MichaelMIL/Desk_Buddy/3d/images/README.md

# Images

Renders and section diagrams of the RoundBot, made with OpenSCAD. The
assembly guide ([`../guide/assembly_guide.html`](../guide/assembly_guide.html))
and the READMEs show them; the "Used in" column says where.

## Lineups and overviews

| File | Shows | Used in |
|---|---|---|
| `c_themes_front.png` | The template and the first twelve themes, from the front | Main README, guide overview, 3d README |
| `c_themes_back.png` | The same thirteen, from the back | Guide overview |
| `c_themes_lap.png` | The ten builds that hold something on their lap, from the front | Main README, guide overview, 3d README |
| `c_themes_lap_back.png` | The same ten, from the back | Guide overview |
| `c_bands_lap.png` | The newer bands, and the Claude cups' engraved faces | Guide, lap themes |
| `c_x_dj.png` | Exploded view of the DJ build | Main README, guide overview |
| `c_x_bare.png` | Exploded view of the template | Guide, template |
| `c_skeleton.png` | The skeleton, front and back | Main README, guide, skeleton |
| `c_plate.png`, `c_plate2.png` | Parts in their print orientation | Guide, printing |

## Assembly steps

| File | Shows | Guide step |
|---|---|---|
| `c_s2.png` | The display sliding into the head shell | 2 |
| `c_g3.png` | The head going onto the neck | 3 |
| `c_g4a.png`, `c_g4b.png` | The wedge key sliding in, and seated | 4 |
| `c_diag_neck.png` | Sections through the neck lock | 4 |
| `c_g5.png`, `c_g5b.png` | The back cap and its posts | 5 |
| `c_g6a.png` | A plug and a cup from the inside: peg, lugs and spring beam | 6 |
| `c_g6b.png` | Side pieces and band going on | 6 |
| `c_diag_twist.png` | Section through the side piece twist‑lock | 6 |
| `c_diag_band_hook.svg` | Section through the band hook in a cup | 6 |
| `c_cradle_in.png`, `c_cradle.png` | The SuperMini sliding into the base plate's cradle, and seated | 7 |
| `c_base2.png` | The base plate going into the body | 8 |
| `c_usb_stops.png` | The USB notch with its two stops, the recess round the top and the sill across the bottom, and the cover beside it | 9 |
| `c_usb_in.png` | The USB cover in place, flush | 9 |
| `c_s8.png` | The finished back, with the USB cover | 9 |

## Not used

These show joints that have since been replaced. They are kept for
reference.

| File | Shows |
|---|---|
| `c_diag_clip.png` | The earlier band clip with two spring arms, next to the twist‑lock section (now `c_diag_twist.png`) |
| `c_base3.png`, `c_s6.png` | The earlier SuperMini mount, which the board was pressed down into |

When a joint changes, render new images here and update the guide; the
guide is the only place most of them appear.
