MichaelMIL/Desk_Buddy/docs/images/README.md

# README images

Pictures for the main [README](../../README.md).

| File | Shows |
|---|---|
| `faces.png` | The common faces: angry, happy, in love, kiss, sleepy, surprised, wink |
| `build_themes.png` | Animations for the build variants: DJ, cat, bear, bunny, king, unicorn |
| `themes.png` | Seasonal themes: Halloween, ocean, space, Christmas |
| `more_themes.png` | Skeleton, gamer, bee, devil, dragon, robot, birthday, valentine, summer |
| `claude_theme.png` | The Claude theme: thinking, writing, hello, spark, pondering, coding, tests pass, debugging, ship it |
| `claude_code.png` | Claude Code moments: reading, searching, editing, todo list, permission, build failed, … done |
| `claude_langs.png` | Claude and programming languages: Python, C++, Go, Rust, JavaScript, TypeScript, Java, C, SQL, bash, polyglot |
| `simulator.png` | The simulator |
| `editor.png` | The animation editor |
| `device_faces.png`, `device_settings.png` | The Faces and Settings web pages the firmware used to serve. The device has no web pages any more, so nothing shows these |

`sim/test/sheet.html?anim=<name>` shows a contact sheet like these for one
animation.
