MichaelMIL/Desk_Buddy/3d/stl/core/README.md

# Core parts

Every buddy needs these five, whatever its theme. Print them once; changing
themes only swaps the body and the accessories.

| File | What it does | Prints | Supports |
|---|---|---|---|
| `head_shell.stl` | Face bezel and display pocket, with a keyhole for a side piece on each side | Face down | None. 0.12 to 0.16 mm layers give a cleaner bezel |
| `head_cap.stl` | Back of the head. Its posts clamp the display, and it closes behind the neck key | Back face down | None |
| `neck_key.stl` | Wedge that slides in behind the display and locks the head onto the neck | Flat, as exported | None. Small and loaded: 4 walls or 100% infill |
| `base.stl` | Bottom plate that snaps into the body, with a cradle the SuperMini slides into from the back | Flat, cradle up | None |
| `usb_cover.stl` | Cover that clicks into the USB‑C notch from outside, flush, against a sill and a recess in the body. Print it in the body's colour | Outer face down | None |

Assembly order and fit tuning are in the
[assembly guide](../../RoundBot_v8_Assembly_Guide.pdf).
