MichaelMIL/Desk_Buddy/3d/stl/accessories/README.md

# Accessories

The side pieces twist‑lock into the keyholes on the head. The band's two
ends hook into the slots on top of a pair of cups, so every band needs two
cups. Builds without a band close the keyholes with plugs or pods.

## Side pieces

Print outer face down, no supports. The spring beam under the peg prints as
a 20 mm bridge, so keep the part fan on.

| File | What it is | Builds that use it |
|---|---|---|
| `cup_left.stl`, `cup_right.stl` | Plain headphone cups with a band slot on top | Every build with a band except Claude. Gamer uses only `cup_right` |
| `cup_mic.stl` | Left cup with a headset mic boom; the boom lies flat on the bed | Gamer |
| `cup_claude_left.stl`, `cup_claude_right.stl` | Cups with the Claude spark engraved 0.6 mm into the outer face | Claude |
| `plug.stl` | Closes a keyhole; fits either side, print two | Template, Skeleton |
| `pod_left.stl`, `pod_right.stl` | Astronaut comms pods, the right one with an antenna. `pod_left` is the same shape as `plug` | Astronaut |

## Bands

Print flat on the back face, no supports. The topper is part of the flat
outline, and so are the two end tabs with their hooks. To take a band off,
push an end in toward the head and lift it.

| File | Topper | Builds that use it |
|---|---|---|
| `band_plain.stl` | None | DJ, Gamer |
| `band_cat.stl` | Cat ears | Cat |
| `band_bear.stl` | Round ears | Bear |
| `band_bunny.stl` | Long ears | Bunny |
| `band_bug.stl` | Two antennae | Bug |
| `band_devil.stl` | Horns | Devil |
| `band_crown.stl` | A crown | King |
| `band_dino.stl` | Plates along the top | Dino |
| `band_unicorn.stl` | A grooved horn between two ears | Unicorn |
| `band_claude.stl` | The spark | Claude |
| `band_robot.stl` | An antenna with a ball | Robot |
| `band_halloween.stl` | A witch hat with a bent tip | Halloween |
| `band_xmas.stl` | Reindeer antlers | Christmas |
| `band_ocean.stl` | A shark fin | Ocean |
| `band_birthday.stl` | A party hat with a pom‑pom | Birthday |
| `band_valentine.stl` | A heart | Valentine's |
| `band_summer.stl` | A sun hat with a wide brim | Summer |
| `band_stpatricks.stl` | A shamrock on a stem | St. Patrick's |

Any band fits any pair of cups, so toppers mix freely. The bodies are in
[`../bodies/`](../bodies/).
