MichaelMIL/Desk_Buddy/3d/images/c_base3.png

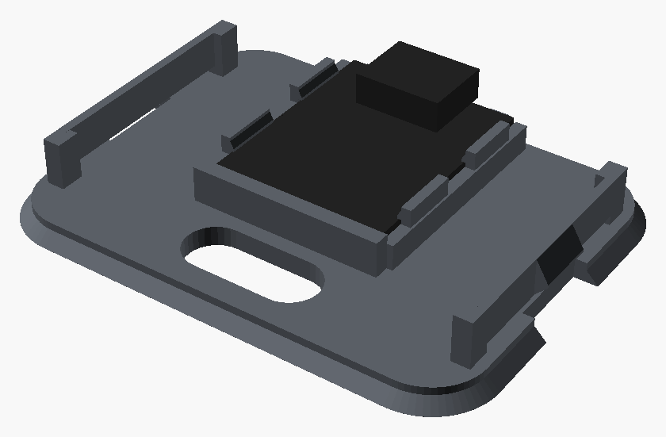
3d/images/c_base3.png
