MichaelMIL/Desk_Buddy/3d/images/c_diag_clip.png

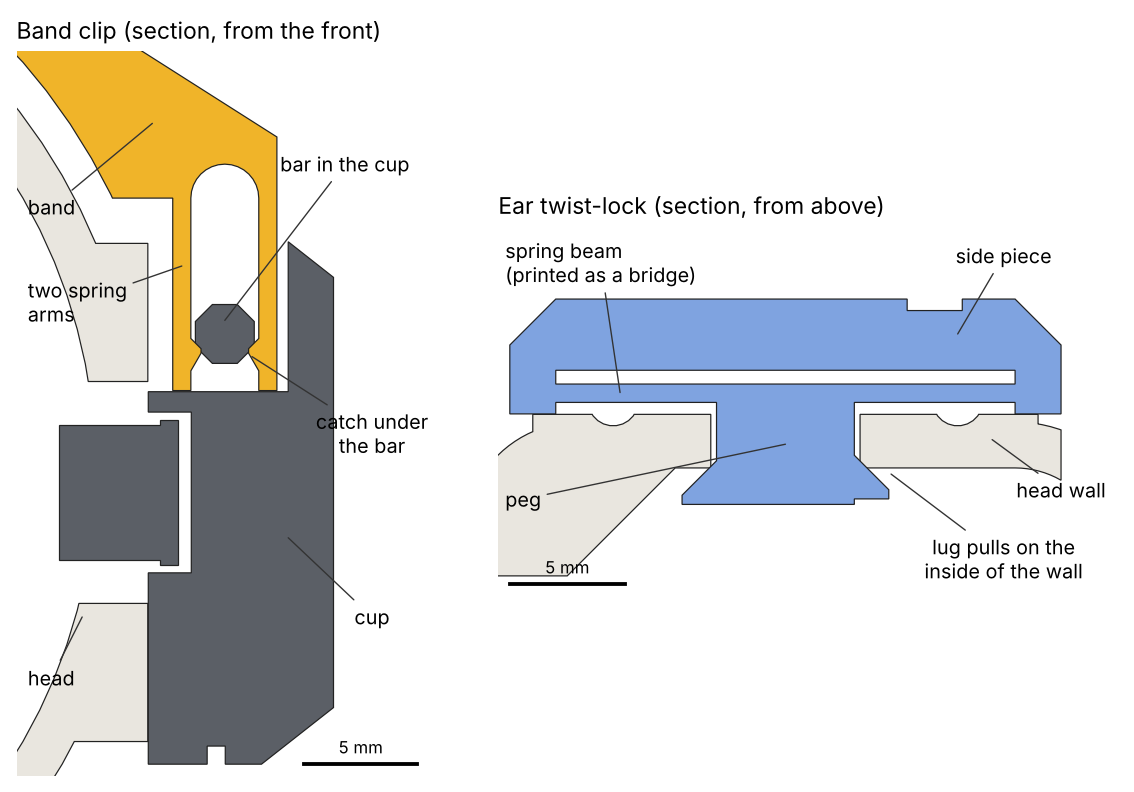
3d/images/c_diag_clip.png
