MichaelMIL/Desk_Buddy/3d/images/c_s6.png

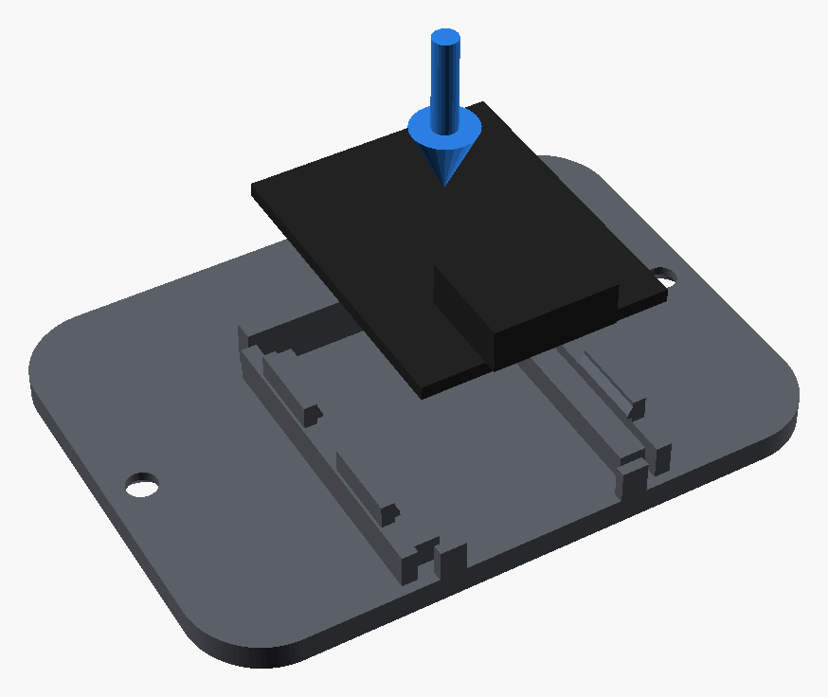
3d/images/c_s6.png
