MichaelMIL/Desk_Buddy/docs/images/device_faces.png

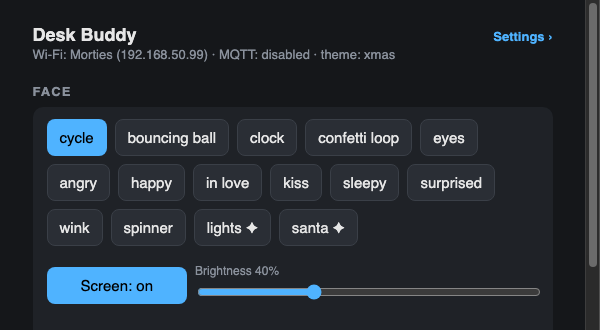
docs/images/device_faces.png
