MichaelMIL/Desk_Buddy/docs/images/device_settings.png

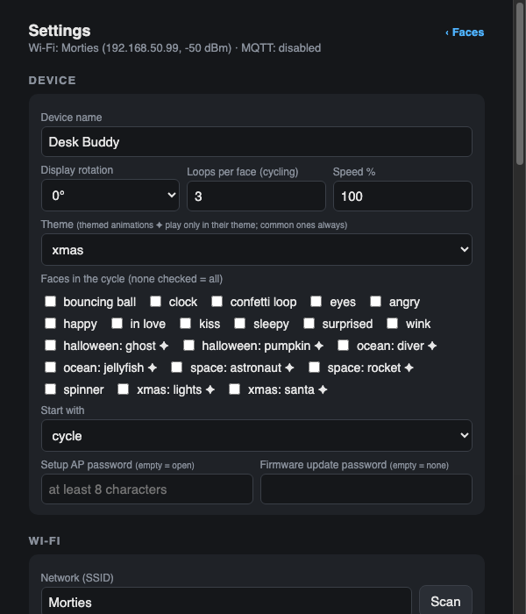
docs/images/device_settings.png
