MichaelMIL/Desk_Buddy/docs/tft_screen_1.PNG

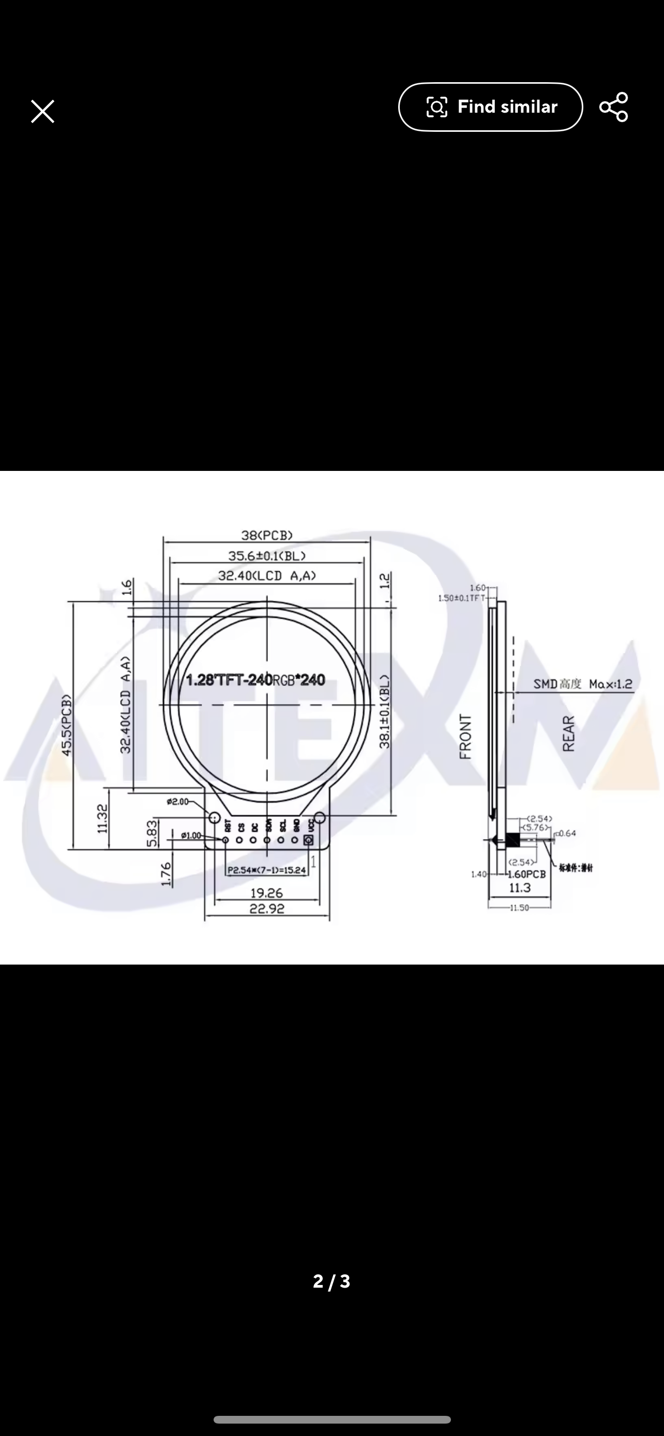
docs/tft_screen_1.PNG
