MichaelMIL/Desk_Buddy/docs/tft_screen_2.PNG

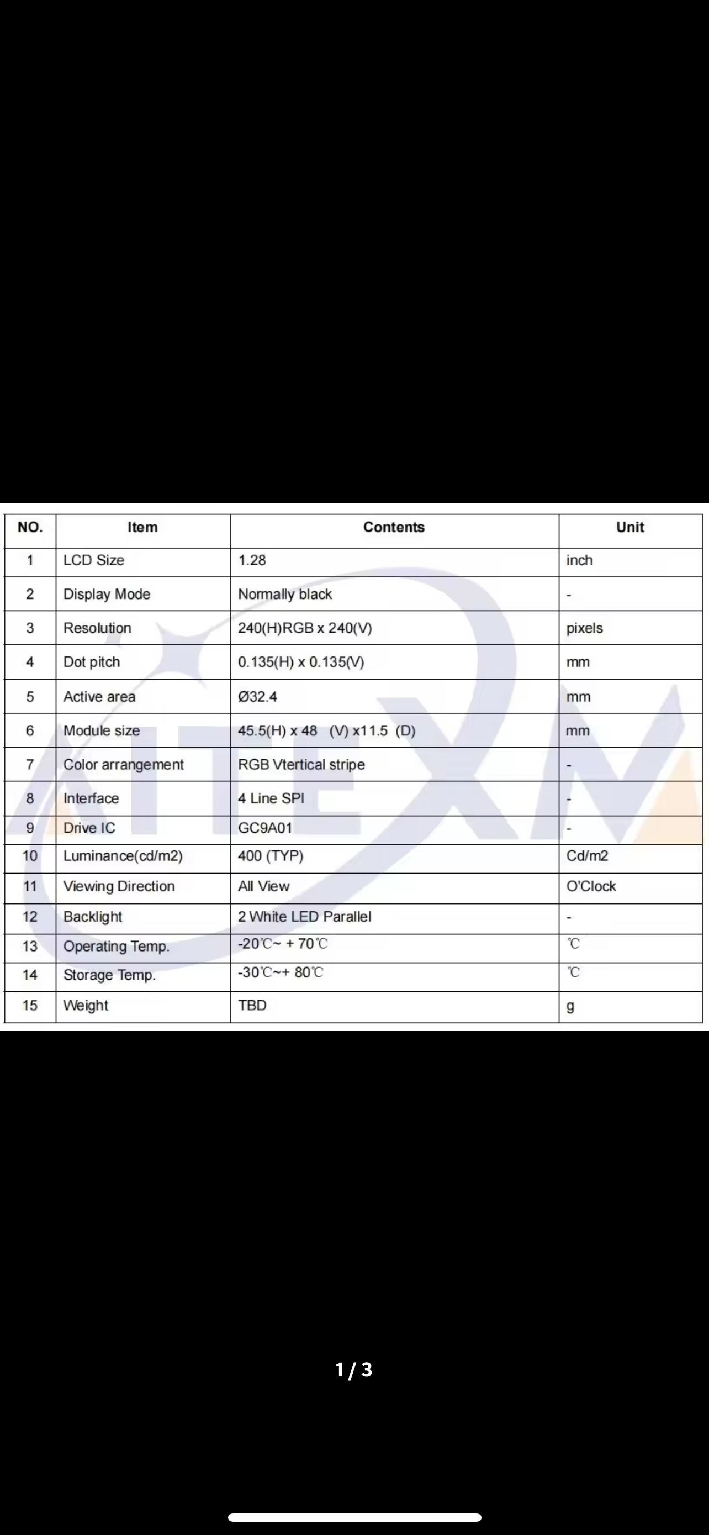
docs/tft_screen_2.PNG
