MichaelMIL/Desk_Buddy/docs/tft_screen_3.PNG

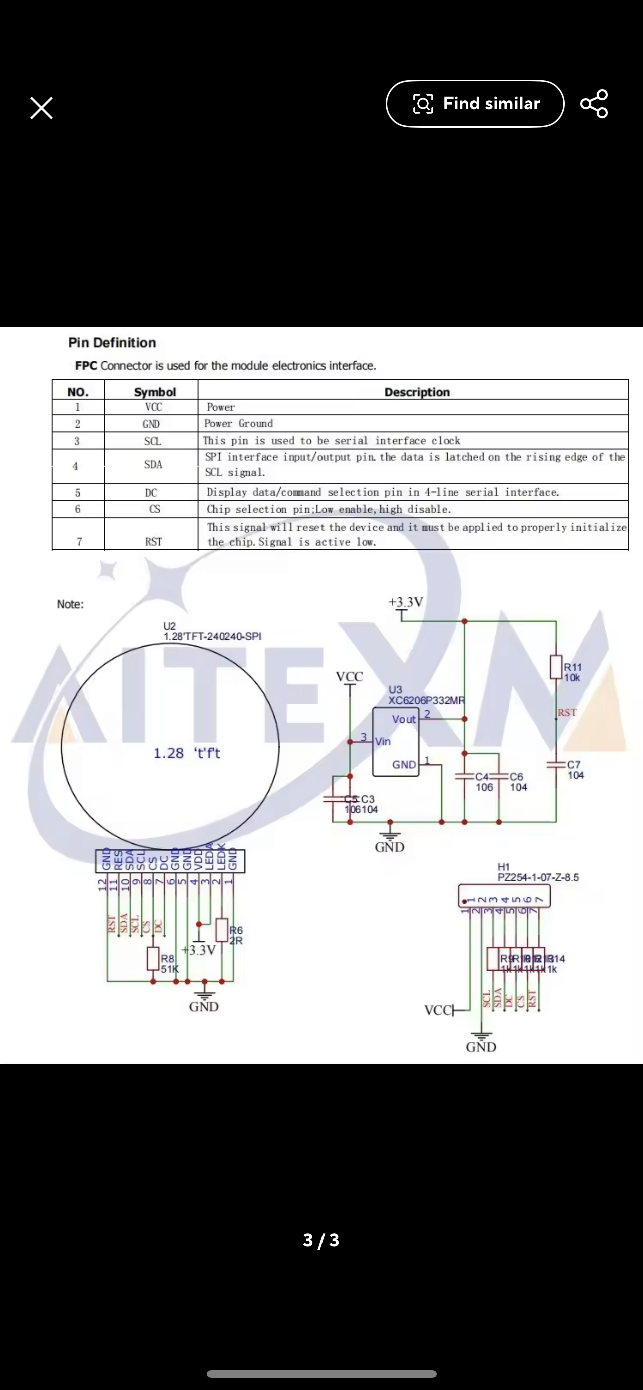
docs/tft_screen_3.PNG
