MichaelMIL/Desk_Buddy/3d/stl/accessories/band_robot.stl

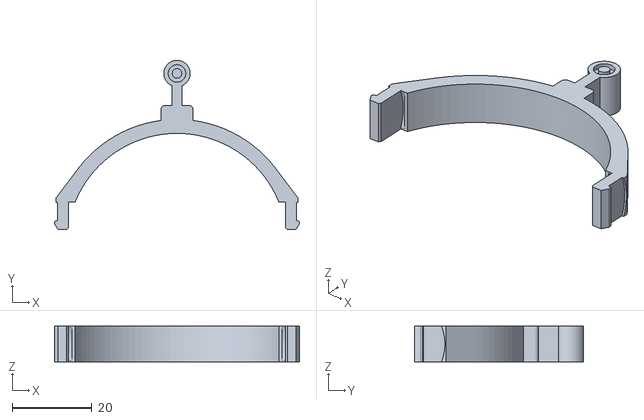
[picture p33: CAD file, 2026-11-12]
3d/stl/accessories/band_robot.stl
61.3 x 42.4 x 9.00
