MichaelMIL/Desk_Buddy/3d/stl/bodies/body_robot.stl

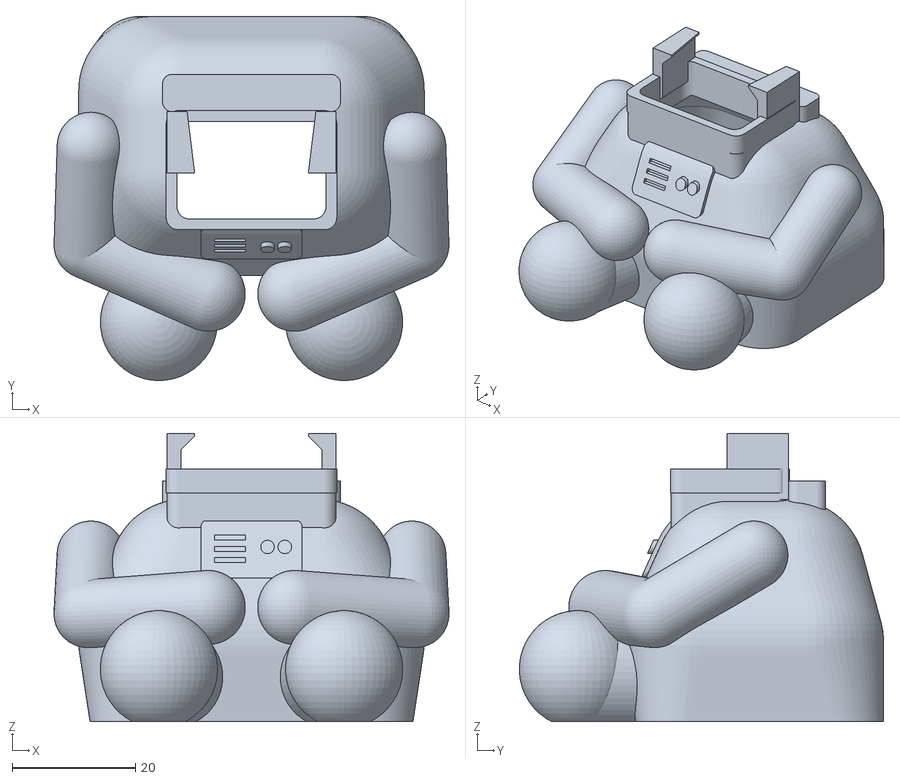
[picture p34: CAD file, 2026-11-14]
3d/stl/bodies/body_robot.stl
64.0 x 59.0 x 46.7
