MichaelMIL/Desk_Buddy/3d/stl/core/usb_cover.stl

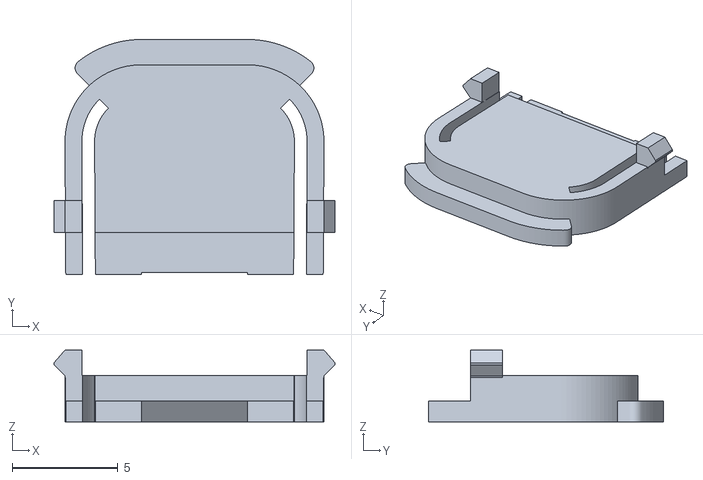
[picture p35: CAD file, 2026-11-14]
3d/stl/core/usb_cover.stl
13.3 x 11.1 x 3.40
