MichaelMIL/Desk_Buddy/3d/usb_variants/b_slide/stl/usb_cover.stl

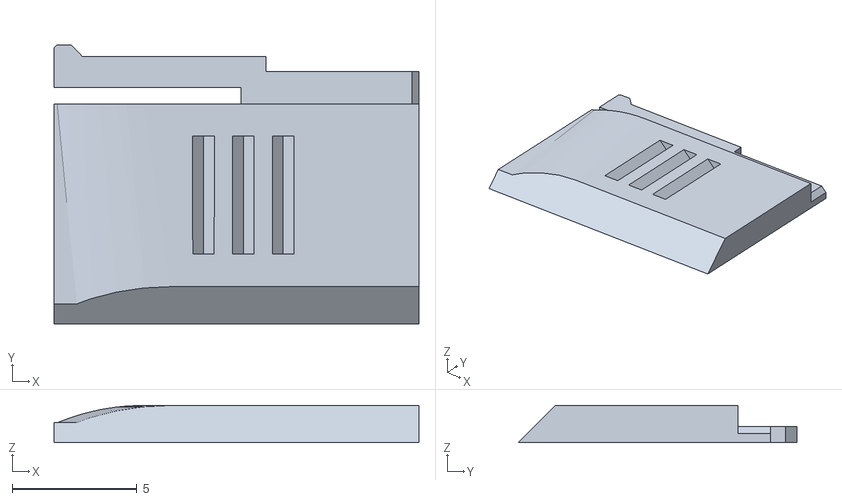
[picture p37: CAD file, 2026-11-14]
3d/usb_variants/b_slide/stl/usb_cover.stl
14.6 x 11.2 x 1.50
