MichaelMIL/Desk_Buddy/3d/usb_variants/d_magnet/stl/usb_cover.stl

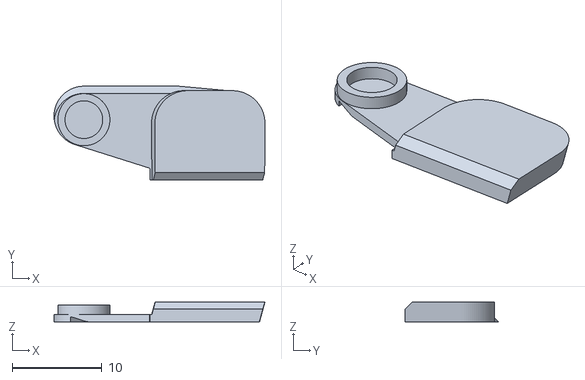
[picture p38: CAD file, 2026-11-14]
3d/usb_variants/d_magnet/stl/usb_cover.stl
23.5 x 10.4 x 2.20
