MichaelMIL/Desk_Buddy/3d/stl/accessories/band_xmas.stl

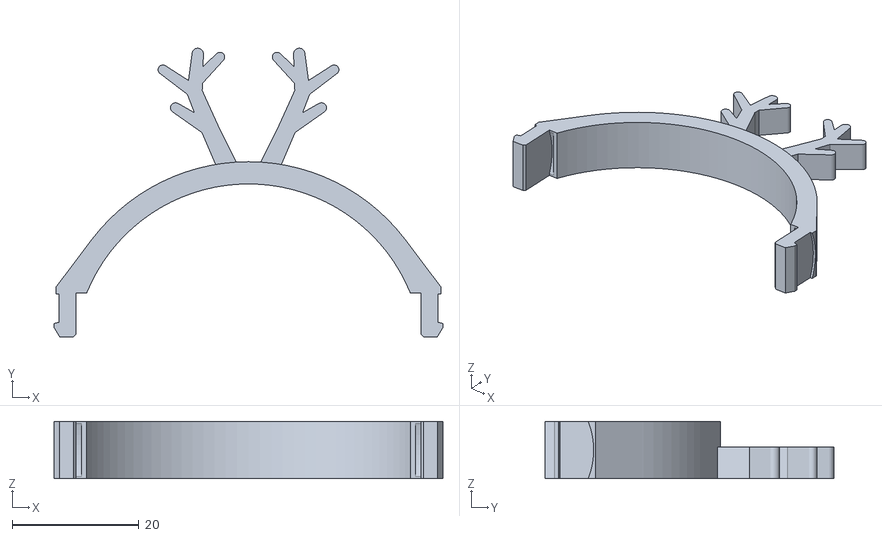
[picture p39: CAD file, 2026-11-12]
3d/stl/accessories/band_xmas.stl
61.3 x 45.5 x 9.00
