MichaelMIL/Desk_Buddy/3d/stl/bodies/body_claude.stl

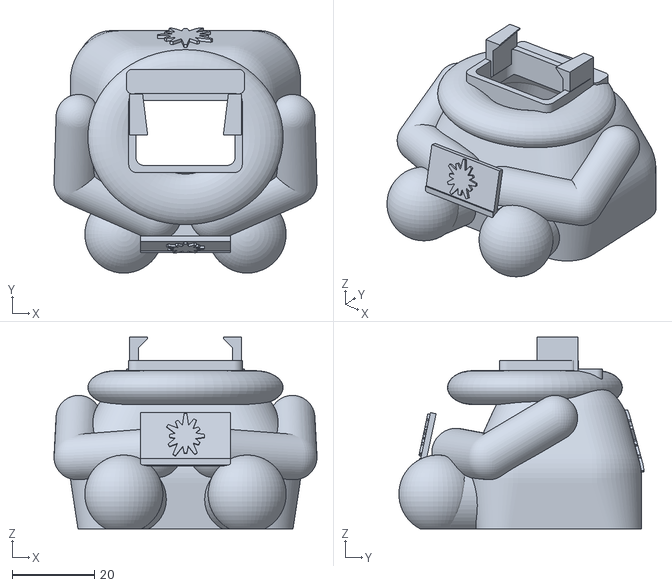
[picture p40: CAD file, 2026-11-14]
3d/stl/bodies/body_claude.stl
64.0 x 59.6 x 46.7
