MichaelMIL/Desk_Buddy/3d/stl/core/base.stl

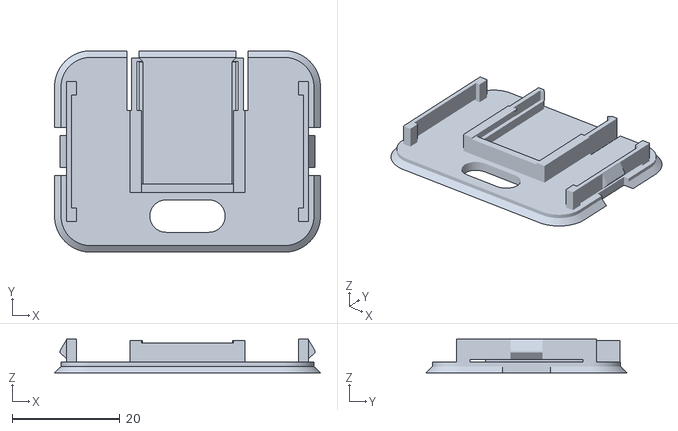
[picture p41: CAD file, 2026-11-12]
3d/stl/core/base.stl
49.4 x 37.4 x 6.30
