MichaelMIL/Desk_Buddy/3d/usb_variants/b_slide/stl/usb_test.stl

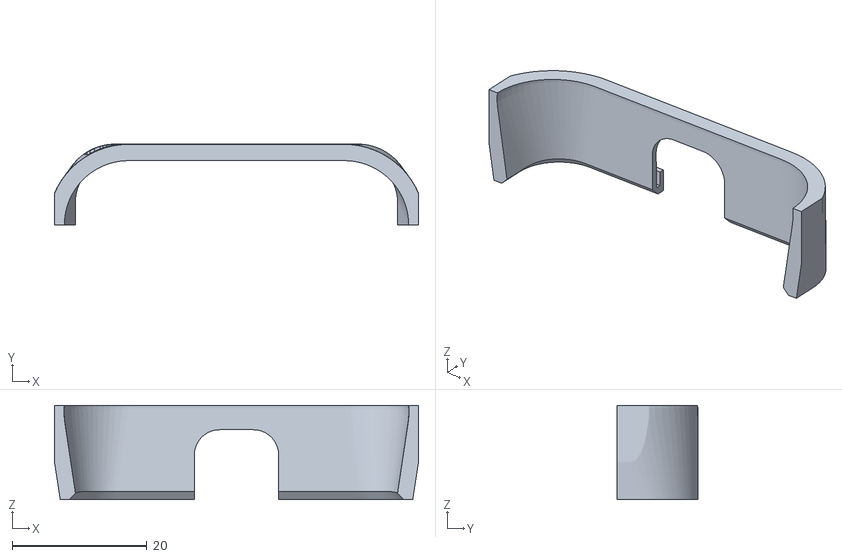
[picture p42: CAD file, 2026-11-14]
3d/usb_variants/b_slide/stl/usb_test.stl
54.0 x 12.0 x 13.9
