MichaelMIL/Desk_Buddy/3d/stl/accessories/band_halloween.stl

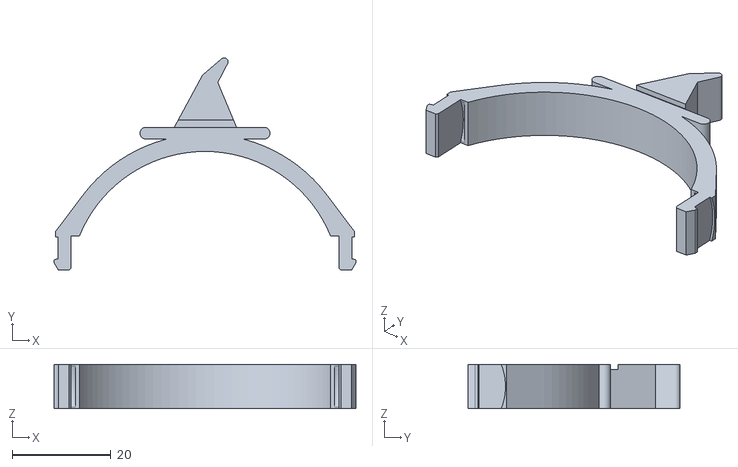
[picture p45: CAD file, 2026-11-12]
3d/stl/accessories/band_halloween.stl
61.3 x 43.1 x 9.00
