MichaelMIL/Desk_Buddy/3d/stl/bodies/body_cat.stl

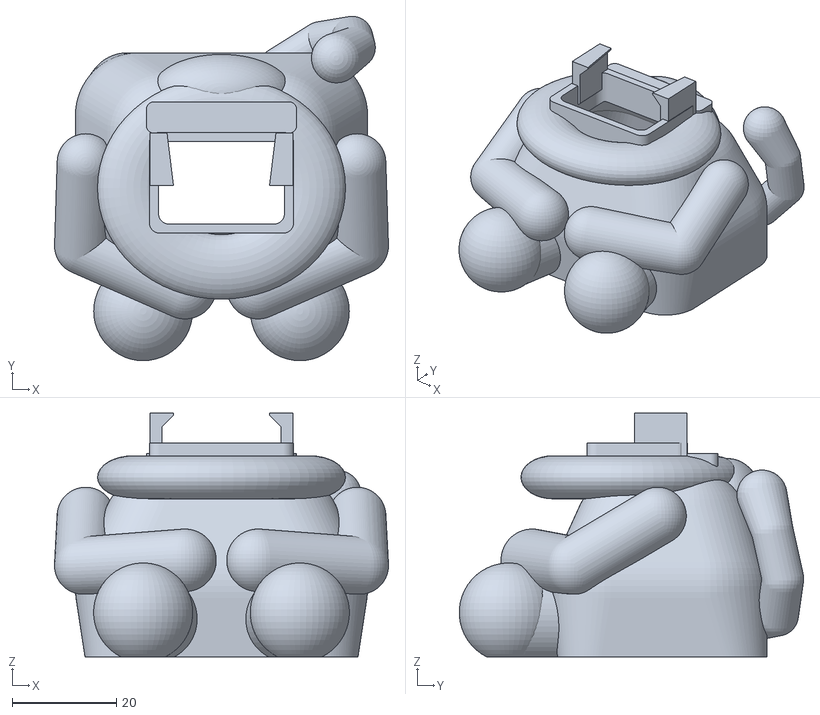
[picture p46: CAD file, 2026-11-14]
3d/stl/bodies/body_cat.stl
64.0 x 66.0 x 46.7
