MichaelMIL/Desk_Buddy/3d/stl/core/neck_key.stl

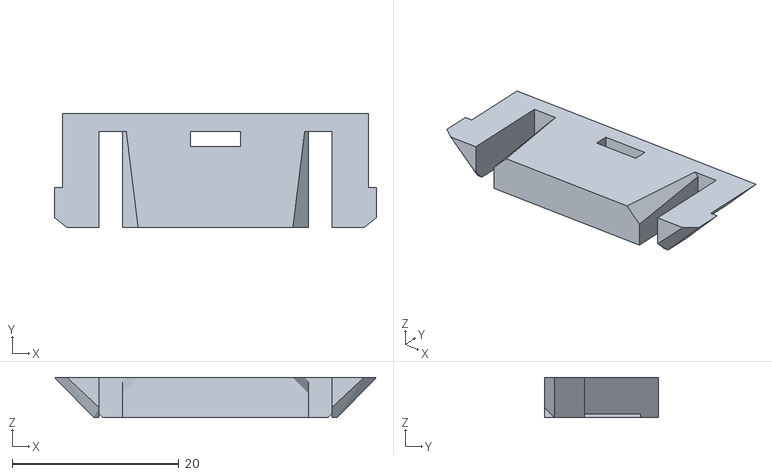
[picture p47: CAD file, 2026-11-11]
3d/stl/core/neck_key.stl
38.6 x 13.7 x 4.80
