MichaelMIL/Desk_Buddy/3d/usb_variants/e_slide/stl/usb_cover.stl

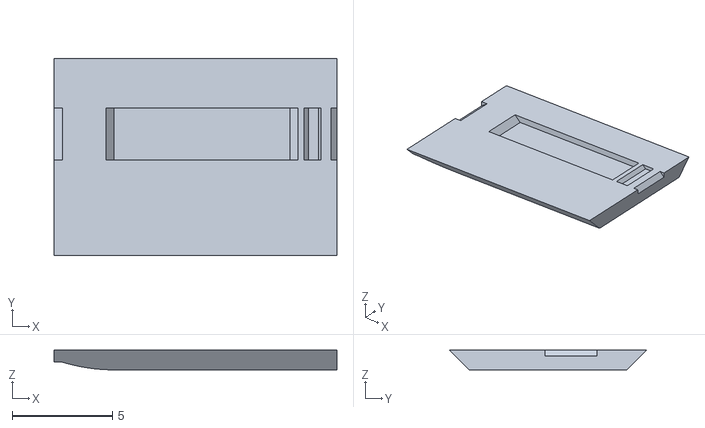
[picture p48: CAD file, 2026-11-14]
3d/usb_variants/e_slide/stl/usb_cover.stl
14.1 x 9.85 x 0.997
