MichaelMIL/Desk_Buddy/3d/stl/accessories/band_stpatricks.stl

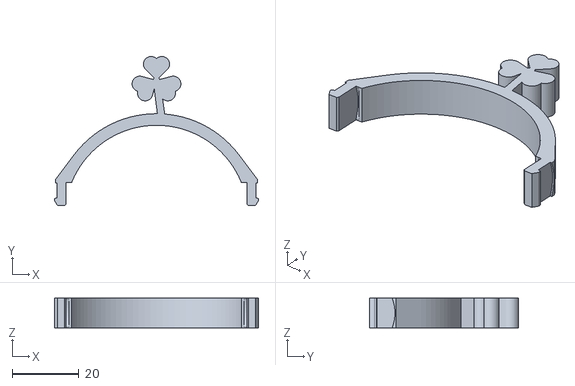
[picture p49: CAD file, 2026-11-12]
3d/stl/accessories/band_stpatricks.stl
61.3 x 44.8 x 9.00
