MichaelMIL/Desk_Buddy/3d/stl/bodies/body_summer.stl

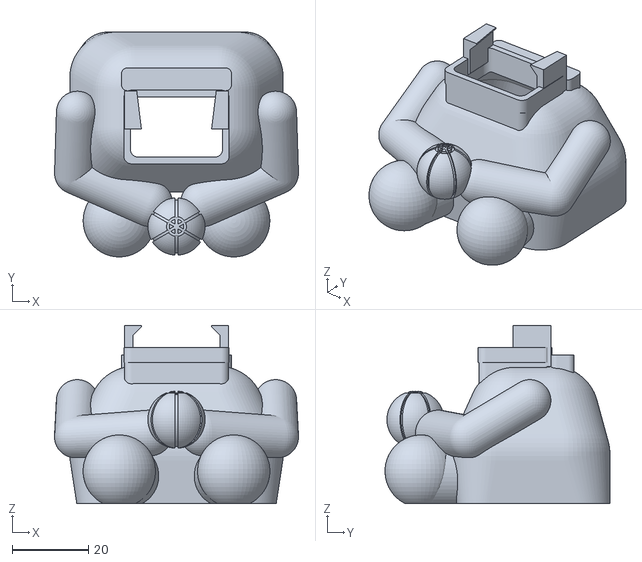
[picture p50: CAD file, 2026-11-14]
3d/stl/bodies/body_summer.stl
64.0 x 59.0 x 46.7
