MichaelMIL/Desk_Buddy/3d/stl/core/head_cap.stl

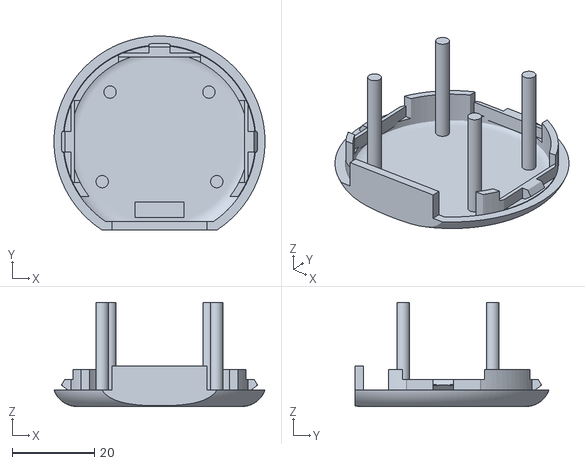
[picture p51: CAD file, 2026-11-11]
3d/stl/core/head_cap.stl
51.3 x 47.2 x 25.3
