MichaelMIL/Desk_Buddy/3d/stl/accessories/band_birthday.stl

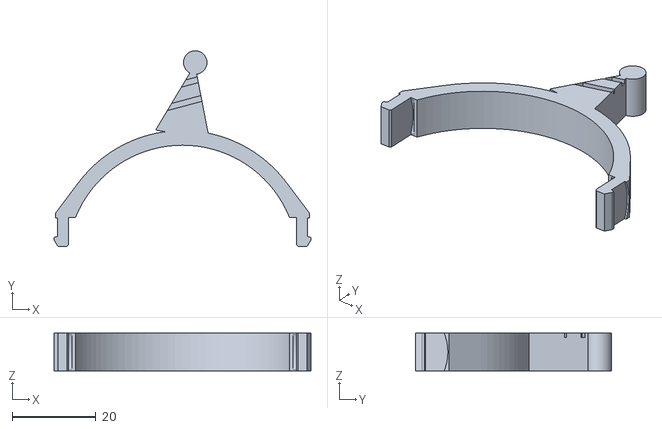
[picture p52: CAD file, 2026-11-12]
3d/stl/accessories/band_birthday.stl
61.3 x 46.6 x 9.00
