MichaelMIL/Desk_Buddy/3d/stl/bodies/body_astro.stl

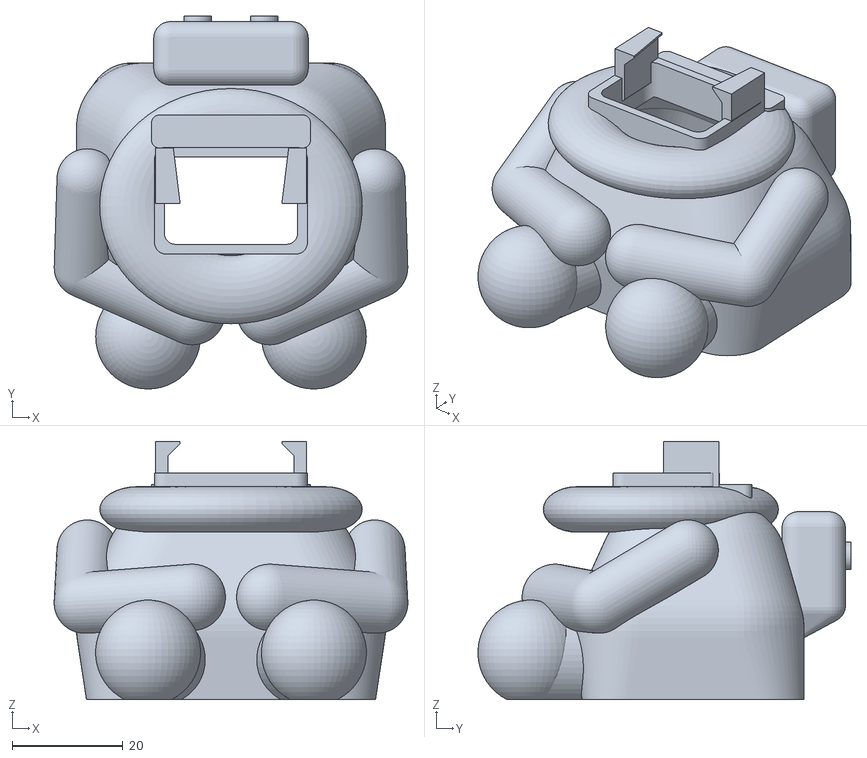
[picture p53: CAD file, 2026-11-14]
3d/stl/bodies/body_astro.stl
64.0 x 67.5 x 46.7
