MichaelMIL/Desk_Buddy/3d/stl/core/head_shell.stl

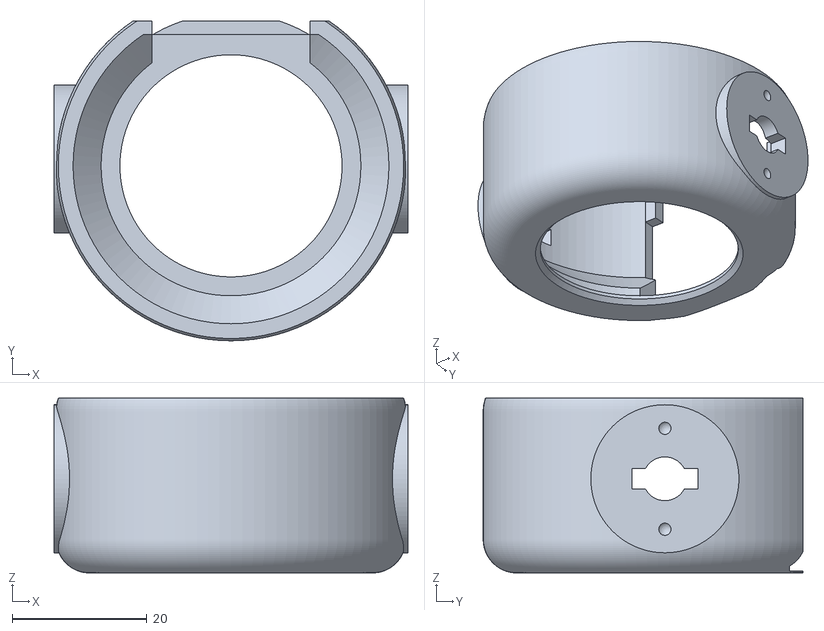
[picture p54: CAD file, 2026-11-11]
3d/stl/core/head_shell.stl
52.6 x 47.5 x 26.0
