MichaelMIL/Desk_Buddy/3d/stl/accessories/band_ocean.stl

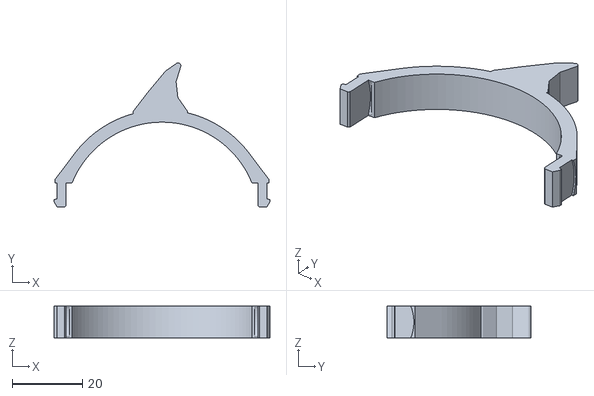
[picture p55: CAD file, 2026-11-12]
3d/stl/accessories/band_ocean.stl
61.3 x 40.9 x 9.00
