MichaelMIL/Desk_Buddy/3d/stl/accessories/band_summer.stl

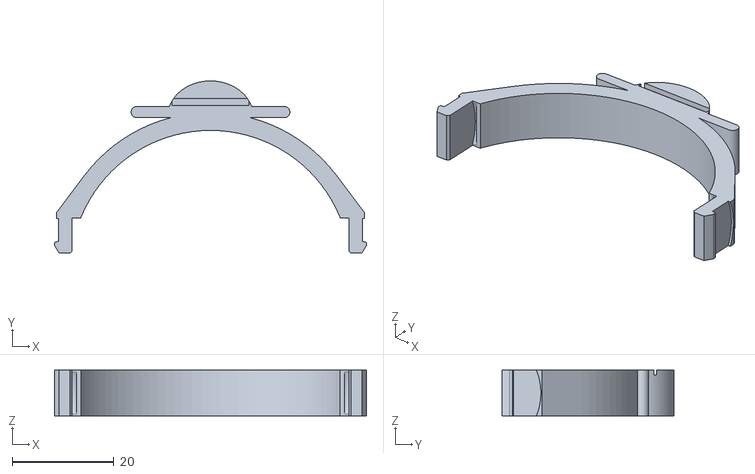
[picture p56: CAD file, 2026-11-12]
3d/stl/accessories/band_summer.stl
61.3 x 33.8 x 9.00
