MichaelMIL/Desk_Buddy/3d/stl/bodies/body_birthday.stl

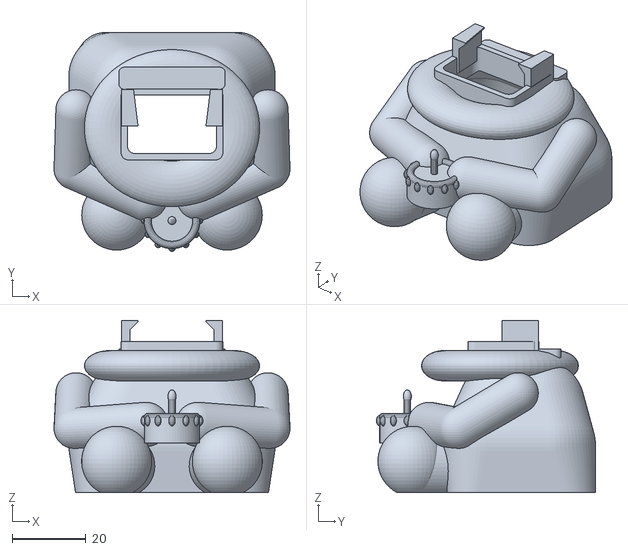
[picture p57: CAD file, 2026-11-14]
3d/stl/bodies/body_birthday.stl
64.0 x 59.4 x 46.7
