MichaelMIL/Desk_Buddy/3d/stl/accessories/band_valentine.stl

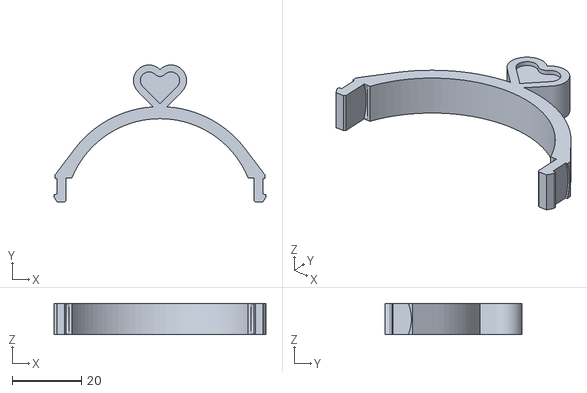
[picture p58: CAD file, 2026-11-12]
3d/stl/accessories/band_valentine.stl
61.3 x 39.6 x 9.00
