MichaelMIL/Desk_Buddy/3d/stl/accessories/cup_claude_left.stl

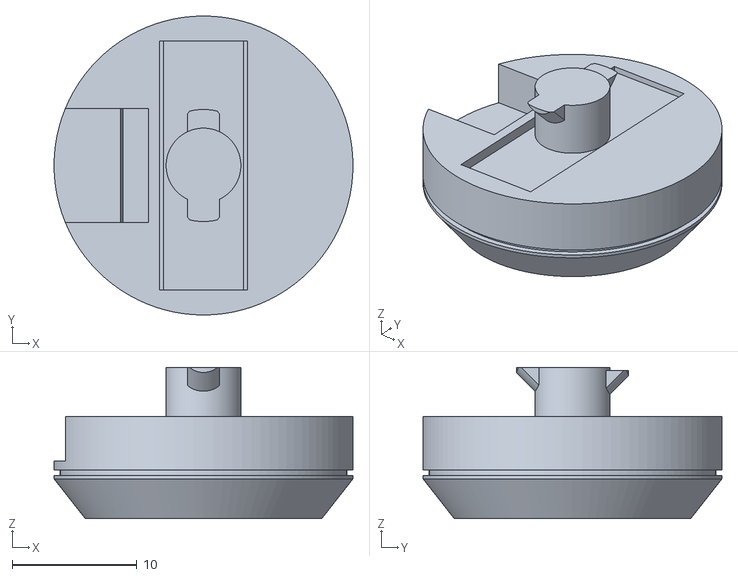
[picture p59: CAD file, 2026-11-12]
3d/stl/accessories/cup_claude_left.stl
24.0 x 24.0 x 12.1
