MichaelMIL/Desk_Buddy/3d/stl/bodies/body_skeleton.stl

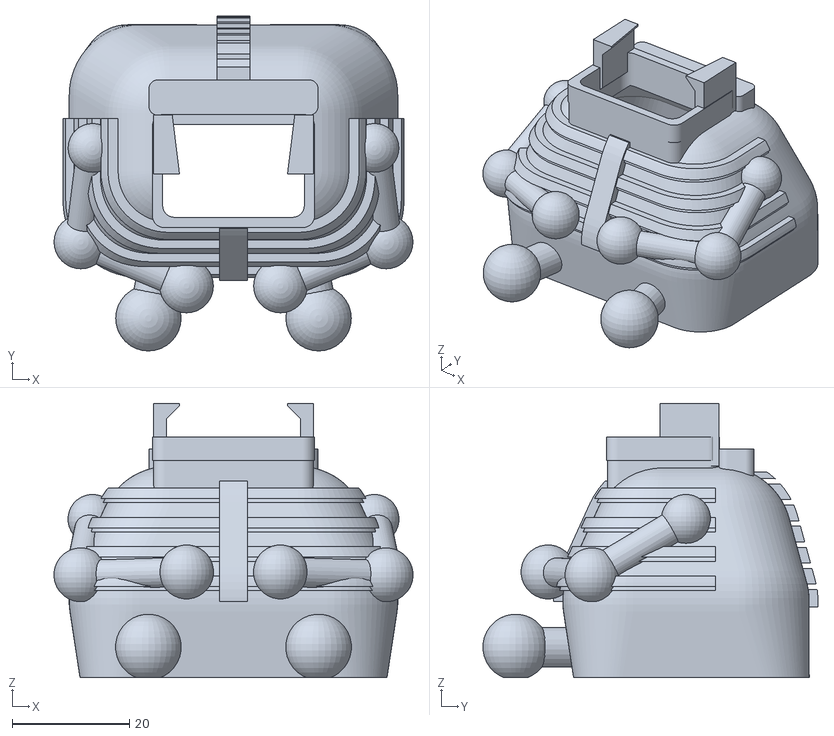
[picture p60: CAD file, 2026-11-14]
3d/stl/bodies/body_skeleton.stl
61.2 x 57.1 x 46.7
