MichaelMIL/Desk_Buddy/3d/stl/accessories/band_claude.stl

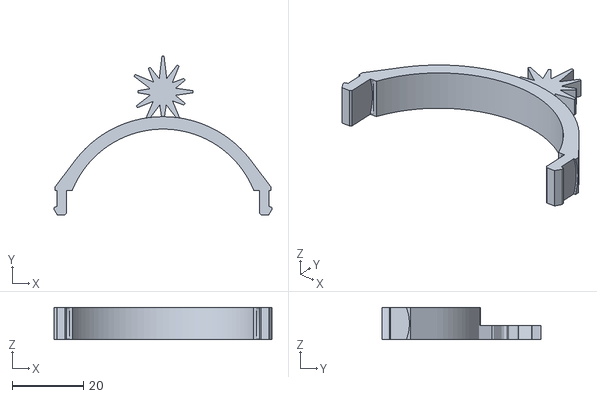
[picture p61: CAD file, 2026-11-12]
3d/stl/accessories/band_claude.stl
61.3 x 44.6 x 9.00
