MichaelMIL/Desk_Buddy/3d/stl/accessories/band_dino.stl

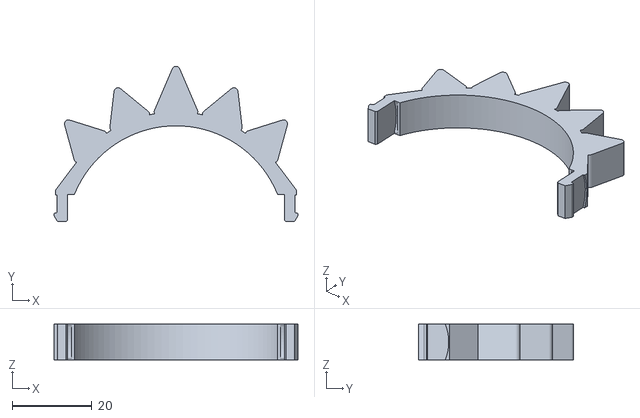
[picture p62: CAD file, 2026-11-12]
3d/stl/accessories/band_dino.stl
61.3 x 39.1 x 9.00
