MichaelMIL/Desk_Buddy/3d/stl/accessories/band_plain.stl

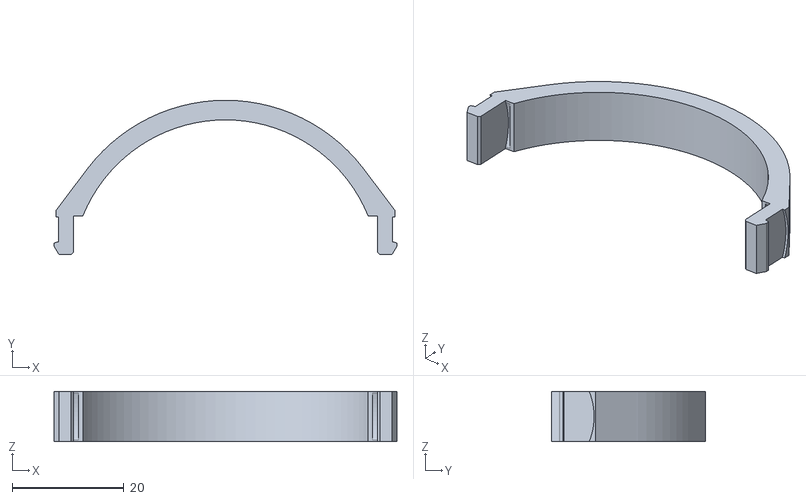
[picture p63: CAD file, 2026-11-12]
3d/stl/accessories/band_plain.stl
61.3 x 27.6 x 9.00
