MichaelMIL/Desk_Buddy/3d/stl/accessories/band_unicorn.stl

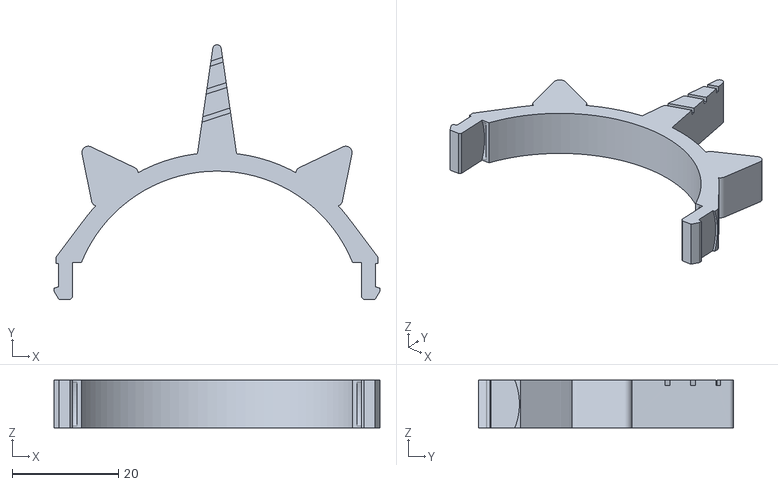
[picture p64: CAD file, 2026-11-12]
3d/stl/accessories/band_unicorn.stl
61.3 x 47.9 x 9.00
