MichaelMIL/Desk_Buddy/3d/stl/accessories/band_devil.stl

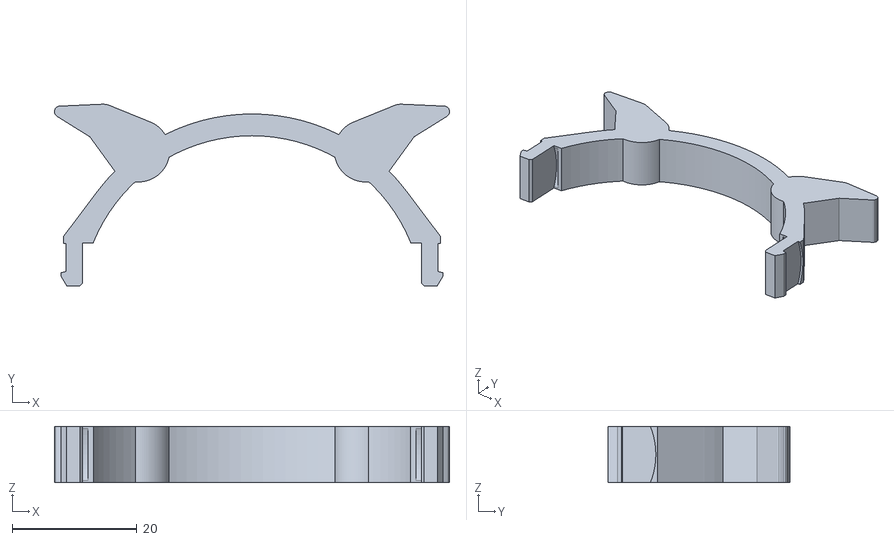
[picture p65: CAD file, 2026-11-12]
3d/stl/accessories/band_devil.stl
63.4 x 29.2 x 9.00
