MichaelMIL/Desk_Buddy/3d/stl/accessories/cup_mic.stl

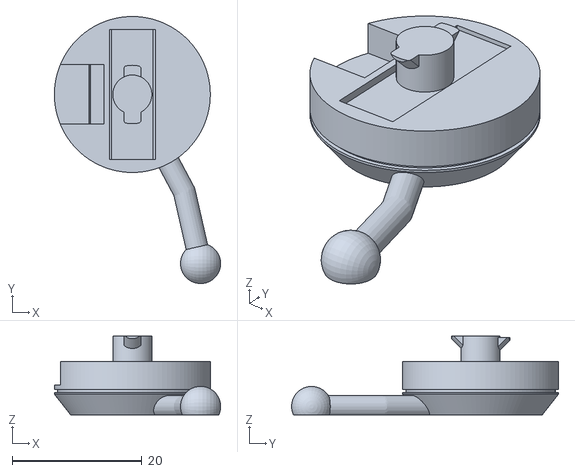
[picture p66: CAD file, 2026-11-12]
3d/stl/accessories/cup_mic.stl
25.6 x 41.1 x 12.1
