MichaelMIL/Desk_Buddy/3d/stl/accessories/band_bear.stl

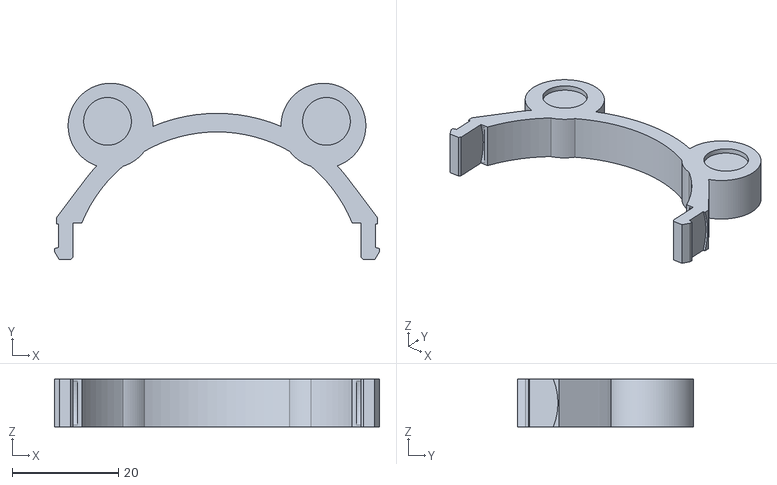
[picture p67: CAD file, 2026-11-12]
3d/stl/accessories/band_bear.stl
61.3 x 33.3 x 9.00
