MichaelMIL/Desk_Buddy/3d/stl/accessories/band_cat.stl

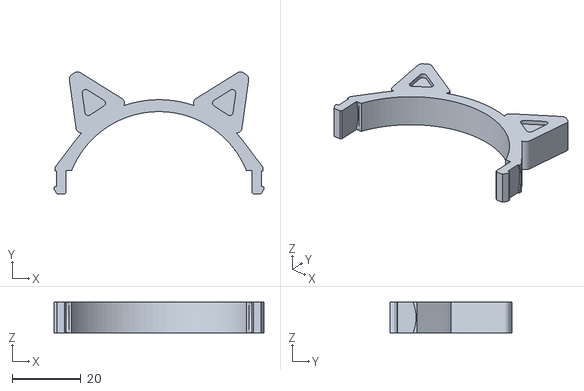
[picture p68: CAD file, 2026-11-12]
3d/stl/accessories/band_cat.stl
61.3 x 35.7 x 9.00
