MichaelMIL/Desk_Buddy/3d/stl/accessories/band_bug.stl

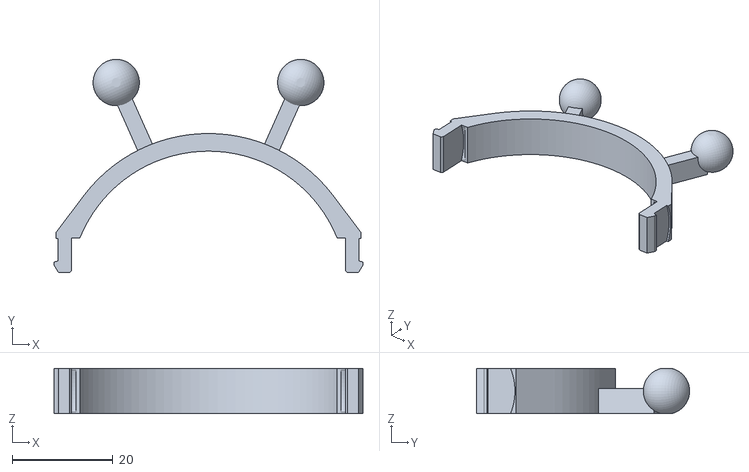
[picture p69: CAD file, 2026-11-12]
3d/stl/accessories/band_bug.stl
61.3 x 42.3 x 9.00
