MichaelMIL/Desk_Buddy/3d/stl/accessories/band_crown.stl

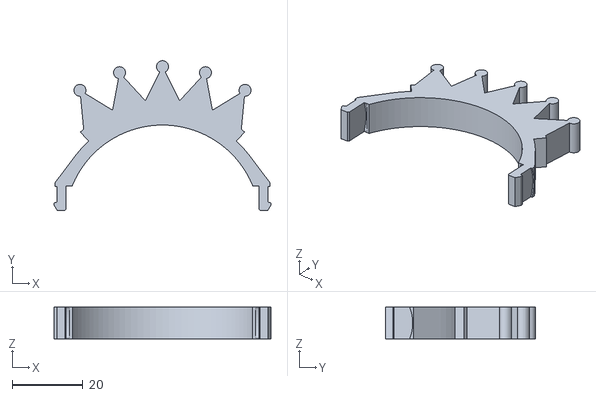
[picture p70: CAD file, 2026-11-12]
3d/stl/accessories/band_crown.stl
61.3 x 42.3 x 9.00
