MichaelMIL/Desk_Buddy/3d/stl/accessories/band_bunny.stl

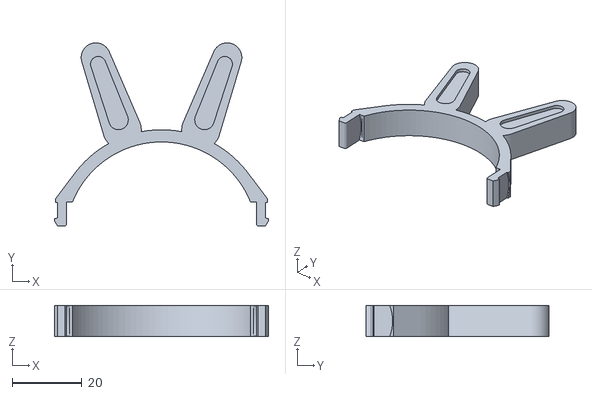
[picture p71: CAD file, 2026-11-12]
3d/stl/accessories/band_bunny.stl
61.3 x 52.5 x 9.00
