MichaelMIL/Desk_Buddy/3d/stl/accessories/pod_right.stl

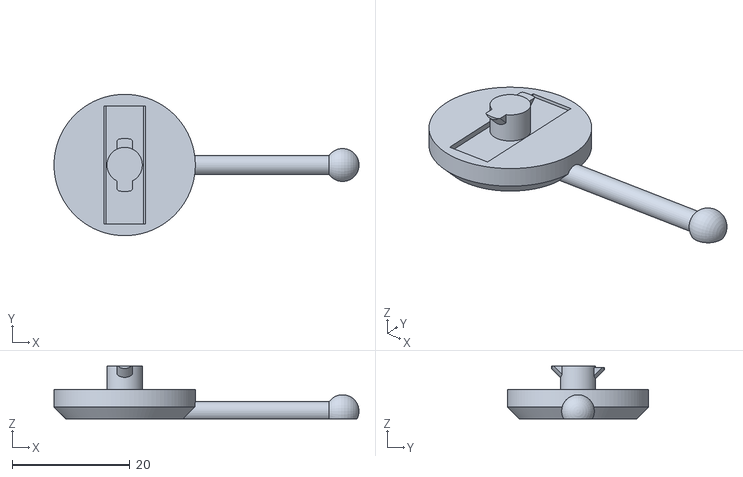
[picture p72: CAD file, 2026-11-11]
3d/stl/accessories/pod_right.stl
51.8 x 24.0 x 8.94
