MichaelMIL/Desk_Buddy/3d/stl/accessories/pod_left.stl

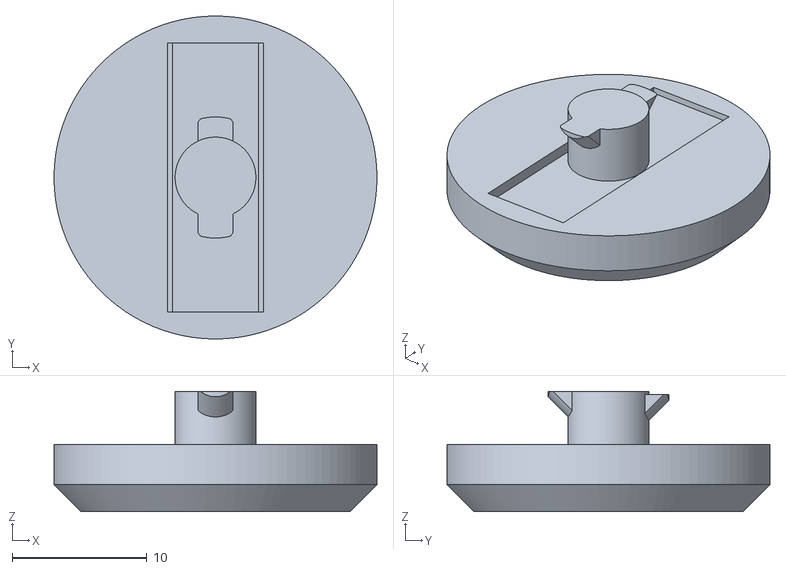
[picture p73: CAD file, 2026-11-11]
3d/stl/accessories/pod_left.stl
24.0 x 24.0 x 8.94
