MichaelMIL/Desk_Buddy/(list of files, cad)

Other CAD files:
3d/usb_variants/e_slide/stl/body_bare.stl
3d/usb_variants/b_slide/stl/body_bare.stl
3d/usb_variants/d_magnet/stl/body_bare.stl
3d/stl/bodies/body_bare.stl
3d/stl/bodies/body_valentine.stl
3d/stl/bodies/body_halloween.stl
3d/stl/accessories/cup_claude_right.stl
3d/stl/bodies/body_stpatricks.stl
3d/stl/bodies/body_ocean.stl
3d/stl/bodies/body_hoodie.stl
3d/stl/accessories/cup_left.stl
3d/stl/bodies/body_gamer.stl
3d/stl/bodies/body_xmas.stl
3d/stl/accessories/cup_right.stl
3d/stl/accessories/plug.stl
