MichaelMIL/Desk_Buddy/tools/firmware/wiring.html

# Desk Buddy firmware

what to connect to what

## Settings

The same settings as on the Build page: change them here or there.

## Parts

## Wiring diagram

## Connections
