MichaelMIL/Desk_Buddy/(commit log)

2026-11-11 Desk Buddy: TFT simulator, Claude chat, ESP32-S3 firmware with OTA, themes and 3D model
    - sim/: browser simulator for the 1.28" round GC9A01 display, pixel-exact
    RGB565 framebuffer, face helpers, themed animations, DBA1/DBAZ export,
    Claude Code chat backend, push-to-board with progress
    - hardware/: PlatformIO firmware for the ESP32-S3 SuperMini: setup AP,
    Wi-Fi, web pages, MQTT + Home Assistant discovery, LittleFS animation
    store with deflate, OTA, two-core rendering, brightness, themes
    - 3d/: RoundBot enclosure (OpenSCAD) and assembly guide
    [band_bear.stl, band_bug.stl, band_bunny.stl, band_cat.stl, band_crown.stl, band_devil.stl, band_dino.stl, band_plain.stl]
2026-11-11 Add root README with images, animation gallery page, pumpkin ridge fix
    [band_bear.stl, band_bug.stl, band_bunny.stl, band_cat.stl, band_crown.stl, band_devil.stl, band_dino.stl, band_plain.stl]
2026-11-11 Add build-variant themes (dj, cat, bear, bunny, king, unicorn) and a third animation per seasonal theme
    [band_bear.stl, band_bug.stl, band_bunny.stl, band_cat.stl, band_crown.stl, band_devil.stl, band_dino.stl, band_plain.stl]
2026-11-11 Crown: four points and gems within the band; push_all accepts a name filter
2026-11-12 Sim: animation editor (visual keyframes + code), FaceRig, shared board module
    - sim/editor.html + lib/editor.js: pose the face on a timeline (sliders,
    poses, draggable keys with easing, undo/redo) or edit any animation as code
    with a live preview; save to sim/animations/, push to the board with progress
    - animations/face_rig.js: keyframed face SPECs (the editor's file format)
    - lib/board.js: board names, rendering to DBAZ and push, shared with app.js
    - simulator: Edit button, editor link, reloads when the editor saves
    - new face made with the editor: Face: giggle
    - also adds animations made with the chat: DJ groove, St. Patrick's (lucky
    clover, lucky hat, pot of gold)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
2026-11-12 Nine new themes, 18 animations: skeleton, gamer, bee, devil, dragon, robot, birthday, valentine, summer
    - FaceRig accepts under/over drawing hooks, so code animations reuse the
    keyframed face and add accessories and props
    - Face.grin draws only the lower half-ellipse: the old background-coloured
    cover box cut into the eyes on wide grins and showed as a dark bar on
    coloured backgrounds (King: coins)
    - gallery.html waits for every animation file before rendering
    [band_bear.stl, band_bug.stl, band_bunny.stl, band_cat.stl, band_crown.stl, band_devil.stl, band_dino.stl, band_plain.stl]
2026-11-12 Every theme has at least three animations: 14 new ones, plus face fixes
    New: Bear snooze, Bee dance, Birthday balloons, Bunny curious, Cat laser,
    Devil trident, Dragon sneeze, Gamer game over, King cheers, Robot error,
    Skeleton laugh, Summer beach ball, Unicorn magic, Valentine kiss.
    - Face.eye: the squint cover ellipse is only painted on the eye's own rows;
    at small squints it sat below the eye and erased whatever was drawn there
    - robot ledEye takes a colour and an 'x' shape
    - clearer text in the gamer animations, skeleton laugh text on the forehead,
    a brighter, shorter dragon sneeze
    - README galleries re-rendered
2026-11-12 Claude theme: 16 more Claude Code moments, shared claude_kit.js
    Reading, grep, a diff, a todo list, a permission prompt, a failing then
    fixed build, a merge conflict, code review, CI, subagents, compacting,
    rubber-duck debugging, an infinite loop, a git graph, plan mode, done.
    The Claude drawing helpers (spark, terminal, spinner, colours) move to
    animations/claude_kit.js so several theme files can share them.
    [serve.py]
2026-11-12 Bands: bigger hook with a friction-locking catch, thicker tab, yoke at the cup
    The bands kept falling out of the cups. The hook is now 0.8 mm (was 0.45) and its
    catch is 15 degrees off flat (was 30), so pulling on the band no longer cams the hook
    out; to remove a band, push its end towards the head and lift. The tab fills the
    slot (0.05 mm at the wall, 0.08 mm front and back) and the band thickens into a
    yoke over its last ~9 mm that sits on the cup past the slot. The cup's decorative
    groove moves out to clear the yoke. All bands and cups re-exported.
    [band_bear.stl, band_bug.stl, band_bunny.stl, band_cat.stl, band_crown.stl, band_devil.stl, band_dino.stl, band_plain.stl]
2026-11-12 Firmware: build without Wi-Fi, uploads over USB and Bluetooth, API docs
    A Bluetooth + USB build (esp32s3_supermini_ble, 3.3 MB LittleFS), one upload
    path shared by HTTP, serial and BLE that refuses a second concurrent upload,
    hardware/API.md and hardware/BLE.md, and the simulator's push to usb / ble.
    [partitions_ble.csv]
2026-11-12 Phone app: Flutter remote for the buddy over Bluetooth LE
    Scan, pairing, remote, console and device status for iOS, Android and macOS,
    with a fake buddy for tests and a device test against a real board.
2026-11-12 3D: Claude build (laptop body, spark band, engraved cups)
    [band_claude.stl, cup_claude_left.stl, cup_claude_right.stl, round_bot.scad]
2026-11-12 3D Claude build: wider spark rays, add body_claude.stl
    The sparks on the lid, back, band and cups get wider rays and blunter tips so they
    print cleanly, and the body STL that was left out of 7b9f707 is added.
    [band_claude.stl, body_claude.stl, cup_claude_left.stl, cup_claude_right.stl, round_bot.scad]
2026-11-12 Phone app: buddy settings, delete, shared links, current firmware
    The firmware now runs every console command for a paired device, so the
    app does more than playback:
    - Buddy settings: rename, Wi-Fi network (quoted names with spaces,
    passwords the buddy would trim are refused), restart. The app expects
    the restart and reconnects (four tries).
    - Long-press a face to play or delete it.
    - The console masks passwords in wifi, mqtt and appass.
    - The scanner also lists buddies already connected to the phone or Mac
    (getSystemDevices): a connected buddy does not advertise.
    - The device name is read from status in both builds; the build without
    Wi-Fi prints "name: X, build without Wi-Fi ..."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
2026-11-12 Firmware: LZMA (DBAL) animations, config commands, USB uploads survive BLE drops
    - store.cpp unpacks the DBAL container (LZMA, lib/dba_player/lzma_dec.c)
    besides DBAZ and raw DBA1
    - the renderer draws a frame's delay-0 records back to back (frames whose
    changes are far apart arrive as several rectangles)
    - new console commands: config (settings JSON), start <name>|cycle,
    ha on|off, otapass; wifi takes a quoted SSID with spaces
    - a Bluetooth disconnect aborts only an upload Bluetooth owns; one running
    over USB carries on
    - firmware 2026.11.12d
2026-11-12 Sim: export animations as DBAL (LZMA), split frames into rectangles
    - lib/lzma.js and tools/dba.py encode DBAL byte-identically; pushes fall
    back to DBAZ for firmware from before DBAL
    - a frame whose changes are far apart becomes several small rectangles
    when that compresses smaller
    - serve.py holds the Claude bridge off the Bluetooth link during ble pushes
    - export_all.html waits until every animation file has loaded
    - tests: LZMA decoder against xz streams, DBAL round trips in JS/Python/C
2026-11-12 Remote page: every console command
    Playback (speed, loops, rotation, start face, cycle list), stored
    animations with upload and delete, Wi-Fi and MQTT settings, device
    actions, and a console; settings come from the new config command.
2026-11-12 Claude Code bridge: drive the buddy over Bluetooth LE
    - host ble / ble:<name>: state, names and play over the Nordic UART
    service with bleak; the link is released 20 s after the last command
    - hold <s> frees the link for uploads; a polyglot activity for languages
    without their own animation
2026-11-12 3D: theme bodies and bands
    Bodies holding a lap item for gamer, robot, halloween, xmas, ocean,
    birthday, valentine, summer and stpatricks; matching bands for all but
    gamer.
    [band_birthday.stl, band_halloween.stl, band_ocean.stl, band_robot.stl, band_stpatricks.stl, band_summer.stl, band_valentine.stl, band_xmas.stl]
2026-11-12 Buddy Bridge: macOS menu bar app for the Claude Code bridge
    claude_integration/menubar/ is a SwiftUI menu bar app (macOS 13+). Its
    icon follows the bridge: the activity on the buddy (reading, editing, ...),
    needs you, holding off, paused, not running, or a warning when the hooks
    are missing or the buddy does not answer. The panel lists the link and
    whether it is connected, each session's project and activity, the recent
    plays, and Pause/Resume, hold, stop, open log and open at login.
    It polls the daemon's GET /status, which now also reports the link,
    whether it is connected, the seconds left of a hold and the daemon's pid.
    build.sh --install builds the .app into ~/Applications; swift test c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
2026-11-12 Assembly guide: every body and accessory, the band hook, the slide-in cradle
    The guide is now built from 3d/guide/assembly_guide.html (node 3d/guide/build_pdf.mjs).
    It lists all 22 builds and all 46 STLs, has a Claude section and the lap-item themes,
    rewrites steps 6, 7 and 9 for the band hook, the ESP32 cradle and the outside USB cover,
    and updates fit tuning (btab_*, mcu_hook, ucv_bite, base_play). New renders: the lap
    themes from the back, the new bands and Claude cups, the cradle, a band hook section.
    README: the body section and the theme lineup point at it.
2026-11-12 Buddy Bridge: buddy controls, Manual mode and hold in the menu bar app
    The daemon owns the buddy link and serves GET/POST /buddy (play, cycle, next, brightness,
    screen, theme); the app shows the buddy's state, a face menu by theme, a Follow Claude /
    Manual switch (pause/resume) and "leave the buddy alone for 2 min" (hold).
2026-11-12 READMEs for 3d/ and docs/ and their subfolders
    What each folder holds, the STLs per folder, every image and where it is used (with the
    guide step), how to rebuild the assembly guide. The root README links 3d/README.md and
    docs/README.md.
2026-11-12 Buddy Bridge: Cycle mode, 3D modeling and design activities
    The menu bar app's switch is Follow Claude / Manual / Cycle; in Cycle the buddy goes
    through the common faces plus one theme's. The bridge plays claude__3d_modeling and
    claude__designing for 3D model and stylesheet/design files and tools.
2026-11-12 Animations: eating, attention, notifications, breaks, silly, rude, scientist theme
    25 new animations:
    - Eat: cookie, noodles, hungry
    - Attention: hey, puppy eyes, knock knock
    - Notify: bell, message, alert
    - Break: coffee, stretch, time for a break, water, breathe
    - Silly: raspberry, cross-eyed, googly eyes, squish
    - rude theme: middle finger, fart, eye roll, talk to the hand (only
    cycles while the rude theme is selected)
    - scientist theme: eureka, experiment, atom (goggles and wild hair)
    hand_kit.js (window.Hands) draws the cartoon hands they share. The
    generic demos move into a template theme (template_*.js) so they leave
    the common cycle.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
2026-11-12 Animation library: re-upload removed animations when they are played
    sim/serve.py saves every push in a local library
    (~/.config/desk-buddy/library or $DESK_BUDDY_LIBRARY) and serves it
    (/api/library); sim/test/library.sh exports every animation into it.
    When a played animation is no longer on the buddy, the Claude Code
    bridge (and the menu bar app through it), the phone app and
    sim/remote.html upload it from the library, deleting the least recently
    played library-backed ones while the buddy is out of space. App builds
    pack the library into assets (tool/sync_library.sh).
    [serve.py]
2026-11-13 Bridge: stop waits until the daemon has exited
    `buddy_bridge.py stop` returned as soon as the daemon answered POST /stop,
    while it was still putting the buddy back and holding the port and the
    Bluetooth link, so `stop && start` found the old daemon and did nothing.
    stop_daemon() now waits for the daemon's pid to go away (up to 60 s).
    install, demo and uninstall use it instead of sleeping for a second.
2026-11-14 3D: stops for the USB cover
    The cover only touched the base plate's cone at its bottom tip, so it
    could be pushed in or tilt. Every body now has two stops 1 mm behind the
    outer face, both outside the cable plug's path: a sill across the bottom
    of the notch (0.6 mm behind the wall's inner face so the USB receptacle
    clears it when the plate goes in) and a recess round the top for a rim on
    the cover. The rim only sits above the spring strips' roots so they stay
    free. ucv_bite 0.3 -> 0.4, so the teeth latch 0.3 mm before the stops.
    All 15 bodies and usb_cover re-exported. Guide steps 8 and 9, fit tuning
    and the PDF updated, with two new images of the stops.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
    [body_astro.stl, body_bare.stl, body_birthday.stl, body_cat.stl, body_claude.stl, body_gamer.stl, body_halloween.stl, body_hoodie.stl]
2026-11-14 Battery level: divider on GPIO 1, low battery alert, shown in every app
    Firmware (hardware/src/battery.*): a 100k/100k divider from the LiPo's B+
    to GPIO 1, read every 2 s through the eFuse-calibrated ADC and mapped to a
    percentage with a LiPo curve. A pull-down probe every 30 s tells a wired
    divider from a floating pin. `battery` / `battery cal <mV>` on the console,
    `bat`/`batLow` in the state JSON, battery in /api/status, an MQTT topic and
    a Home Assistant sensor. At 15 % (until 20 %) the buddy plays battery_low
    (or a text screen) every 5 min, every minute at 5 %, then resumes.
    New animation "Battery: low" (sim/animations/battery.js); battery_* names
    never join the cycle. The phone app, s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
2026-11-14 Firmware builds without battery level; low battery alerts take turns
    BUDDY_BATTERY=0 (envs esp32s3_supermini_nobat, esp32s3_supermini_ble_nobat,
    hardware/ota.sh --nobat) compiles the battery measurement and alerts out,
    ~11 KB less; state, config and /api/status then carry no battery fields,
    so every client shows none. Same partition tables, so switching keeps the
    stored animations. Replaces -DBAT_PIN=-1.
    Low battery alerts now rotate through the battery_* animations on the
    buddy in name order, with battery_critical first at 5 % and below when the
    buddy has it; the text screen when there are none.
    [battery.cpp, battery.h, config.h, main.cpp, net.cpp]
2026-11-14 Charging: the charger's CHRG/STDBY pads, charging alerts, shown in every app
    The TP4056's status pads go through Schottky diodes to GPIO 2 (CHRG) and
    GPIO 4 (STDBY) with the internal pull-ups (BAT_CHRG_PIN / BAT_STDBY_PIN);
    a change counts once it holds for 2 s. Unwired, nothing changes.
    Plugged in: charging_plugged_in, then every 10 minutes while charging the
    other charging_* in turn; charged: charging_full once per time on the
    charger. No low battery alerts while on the charger. charging_* never
    join the cycle.
    The state and battery JSON carry "chg":"charging"/"full" while on the
    charger; the phone app, sim/remote.html, the bridge and the menu bar app
    show a bolt or "charged", and a low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
2026-11-14 Battery and charging animations
    Low battery alerts (the firmware plays them in turn, battery_critical at
    5% and below): plug me (a USB-C plug dangles, puppy eyes, "plug me in!"),
    please (praying hands, speech bubbles, a tear), sos (the eyes blink
    S-O-S in Morse), hungry (chomps at a passing lightning bolt), faint
    (spiral eyes, X eyes, drops off screen, comes back) and critical (the
    picture collapses like an old TV switching off).
    Charging faces, stored as charging_* so the low rotation never picks
    them: plugged in and full (loop: false, played once on plug-in and when
    charged), power up (a gradient ring round the edge fills, each segment
    keeps its colour so frames stay small), sip (a batter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
2026-11-14 Battery and charging animations: random picks from pools, with settings
    The firmware sorts battery_* and charging_* animations into five pools by
    name (low, critical, plugged, charging, full) and plays a random one from
    the pool (not the same one twice in a row), at random times between half
    and one and a half times the interval. An empty critical pool uses the
    low one, an empty plugged pool the charging one.
    Settings, saved on the buddy: `alerts low off|<min>` (default 5) and
    `alerts charging off|0|<min>` (default 10; 0 = only when plugged in and
    when charged); `alerts test <pool>` plays one now. Also in config, and
    alertLow / alertCharging in POST /api/config. The phone app and
    sim/remote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
2026-11-14 Docs: hardware/PINOUT.md, parts and wiring on one page
    Every GPIO, the parts list, and the display, battery and charger wiring,
    linked from the README, hardware/README.md and CLAUDE.md.
2026-11-14 Tools: firmware builder GUI (Wi-Fi, Bluetooth, USB serial only, battery) in tools/fw_builder
    fw_builder.py opens a local page (127.0.0.1, random token) to pick the
    settings in options.json. Each setting maps to a PlatformIO environment and
    -D flags. It builds in hardware/.pio/fw_builder, copies the firmware to
    tools/fw_builder/out/ (ignored), and can flash over USB or update over
    Wi-Fi. It also has --list, --plan and --build on the command line. Tests:
    python3 tools/fw_builder/test_fw_builder.py.
2026-11-14 Tools: firmware Wiring tab, charging status toggle, buddy-themed look
    wiring.html, a third tab: what to connect to what for the selected
    settings. An SVG diagram shows the display on the SuperMini, and with
    battery level the LiPo, TP4056 charger, 1N5817, divider and (with charging
    status) the BAT54s to CHRG / STDBY. Below it a connection table with a
    check after each stage and the parts list, all changing with the toggles,
    which are shared with the Build tab. Pins are not typed in: POST
    /api/wiring resolves the macros the build would see (header defaults,
    the env's platformio.ini build_flags following extends, then the
    settings' -D flags), so moved or disabled pins show up. Scrolls sideways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
2026-11-14 Tools: firmware flash layout map and animation capacity estimate
    The Build tab has a Flash layout card for the selected settings. It draws
    the build's partition map over the 4 MB flash, address 0 on the left:
    bootloader, partition table, settings, OTA state, app slot(s),
    animations (LittleFS), crash dump. A table of offsets and sizes sits
    below. The app is shaded by the firmware size once that exact build
    exists. The Flash tab shows the same map for the chosen image (from its
    partition table) and a small one for the board after Connect.
    The estimate counts how many animations fit in the LittleFS partition.
    Files take whole 4 KB blocks, the directories a few, and uploads keep
    FS_MARGIN free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
2026-11-14 3D: USB cover variants to print and compare
    3d/usb_variants/ holds four ways to cover the USB-C notch: A (the
    click-in cover in round_bot.scad today), B (slide), D (magnet) and E (a
    second slide fixing the first print round's feedback). Each has its own
    .scad including round_bot.scad, STLs (a 15-minute test coupon, the cover,
    the bare body), pictures and a README; compare.png shows them side by side.
    round_bot.scad gets an empty usb_body_extra() hook for their body parts.
    [body_bare.stl, round_bot.scad, usb_clip.scad, usb_cover.stl, usb_magnet.scad, usb_slide.scad, usb_slide2.scad, usb_test.stl]
2026-11-14 App: animation previews, gallery and theme colors
    The app now plays the animations themselves instead of emoji. lib/dba.dart
    is a Dart port of hardware/lib/dba_player/ (DBAL/DBAZ containers, LZMA,
    DBA1 frames to RGBA), and test/dba_test.dart checks it against
    sim/tools/dba.py with two fixtures. lib/previews.dart decodes them on a
    background isolate and caches them.
    - Remote: the round screen in its bezel plays the buddy's animation.
    - Previews: tap a face to watch it at the buddy's speed, with its theme,
    length and size, then play it, send and play it, switch to its theme or
    delete it; swipe for the next one. Press and hold still plays at once.
    - Gallery: every animation, on the buddy o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
2026-11-14 Firmware: two Bluetooth connections, confused and hello alerts, updates over Bluetooth
    Two connections (CONFIG_BT_NIMBLE_MAX_CONNECTIONS=2): the buddy keeps
    advertising while one device is connected, each gets the replies to its
    own commands, state notifications go to both, uploads run one at a time.
    So the phone and the Mac running the Claude Code bridge can both be on.
    - Two remotes at once: when both send commands that change the screen
    within 3 s, it plays a random confused_* animation (a text screen
    without one), at most every 15 s, then follows the later command.
    - Hello: a paired device connecting after 10 minutes or more away gets a
    random connected_* animation.
    - Both are new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
    [partitions_ble_ota.csv]
2026-11-14 Tools: firmware updates over Bluetooth
    A new "Updates over Bluetooth" setting builds with -DBUDDY_BLE_OTA=1
    (without Wi-Fi through an env_rules entry: esp32s3_supermini_ble_ota).
    "Update over Bluetooth" on the Build tab, or --upload ble[:<name>][@password],
    sends the .bin with the update command over bleak, after asking the Claude
    Code bridge to stay off the buddy. forces are followed through (USB serial
    only turns Bluetooth off, which turns the updates off), and a build whose
    environment is not in platformio.ini is refused. 26 tests.
2026-11-14 App and remote page: the confused and connected alert pools
    alertPoolOf (app) and poolOf (sim/remote.html) now mirror the firmware's
    pool_of() again: confused_* ("Two remotes at once") and connected_*
    ("Device connected") are listed in the alerts card with a Try button.
    The card is called "Alerts" now, since it is no longer only battery and
    charging. The app's cycle preview leaves out every alert, not only the
    battery and charging ones. Tests cover the new pools and their Try.
